silver-sat/Ground_Radio_Board/README.md

# Ground_Radio_Board
Silversat Ground Station Radio Board
