silver-sat/Ground_Radio_Board/image.png

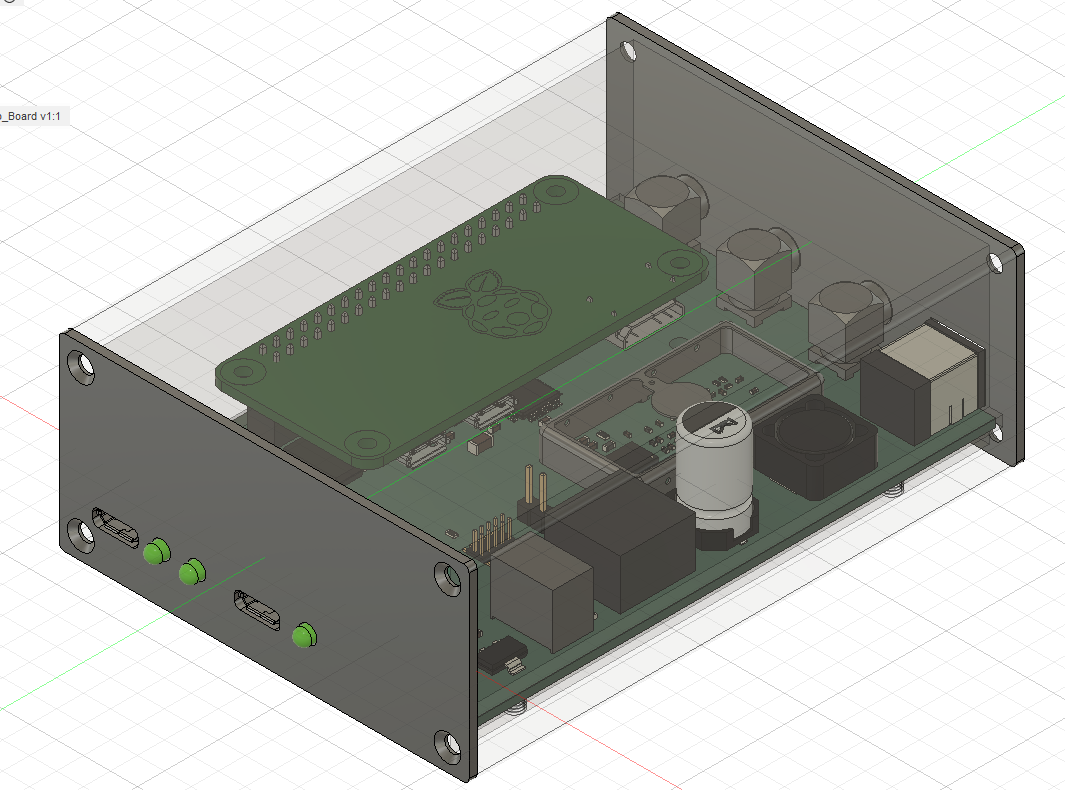
image.png
