silver-sat/Ground_Radio_Board/HeatSpreader.step

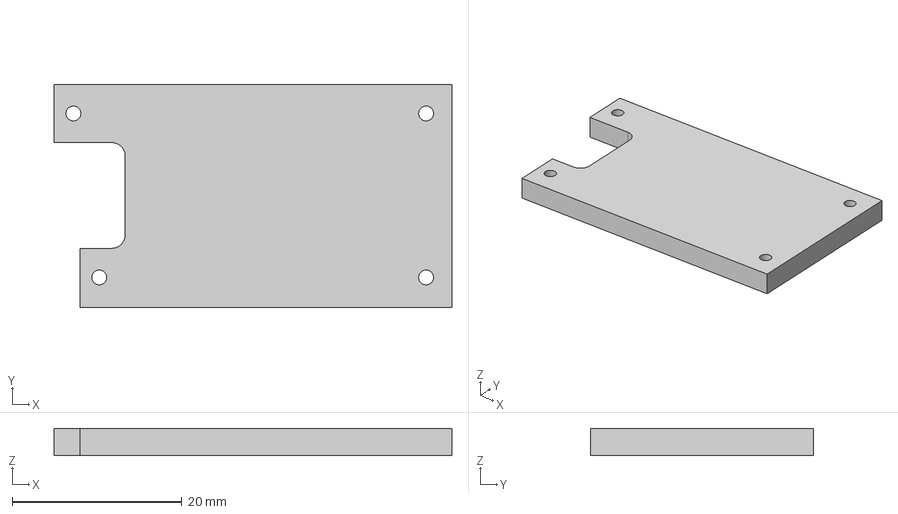
[picture p2: CAD file, 2024-04-20]
HeatSpreader.step
46.9 x 26.3 x 3.20 mm
