silver-sat/Ground_Radio_Board/3D Models/A785MW477M1VLAS015.step

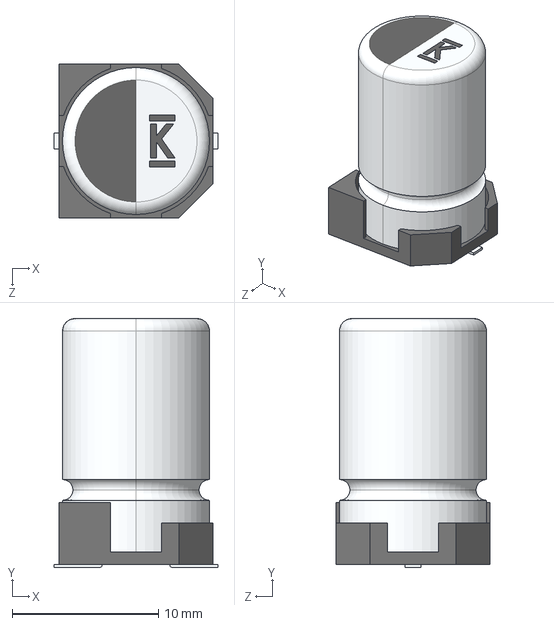
[picture p3: CAD file, 2024-08-07]
3D Models/A785MW477M1VLAS015.step
11.2 x 17.0 x 10.5 mm
