silver-sat/Ground_Radio_Board/3D Models/tsr1e_3d_drawing.stp

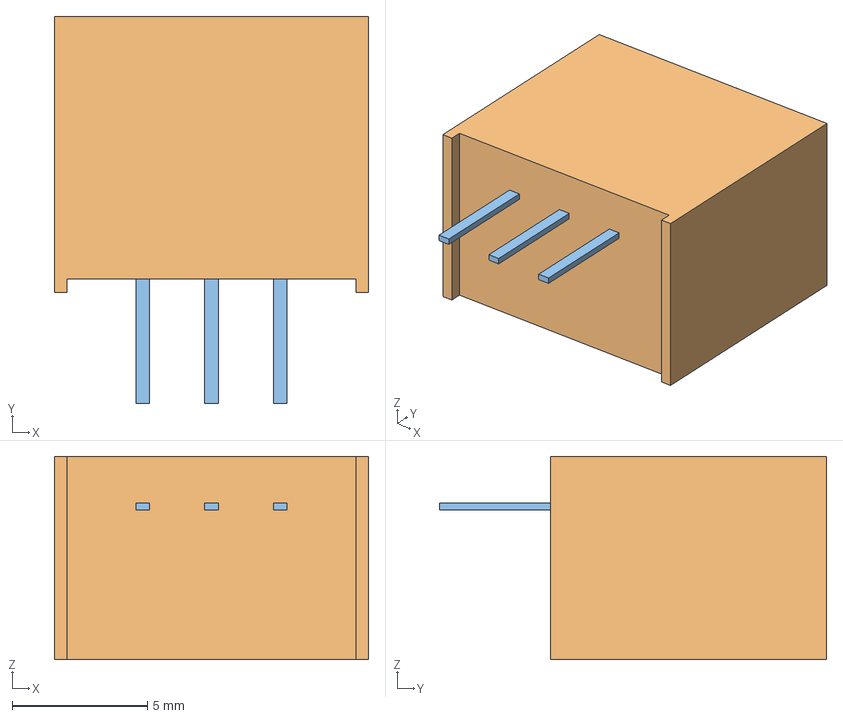
[picture p4: CAD file, 2024-08-07]
3D Models/tsr1e_3d_drawing.stp
11.6 x 14.3 x 7.50 mm
