silver-sat/Ground_Radio_Board/3D Models/srr1260.stp

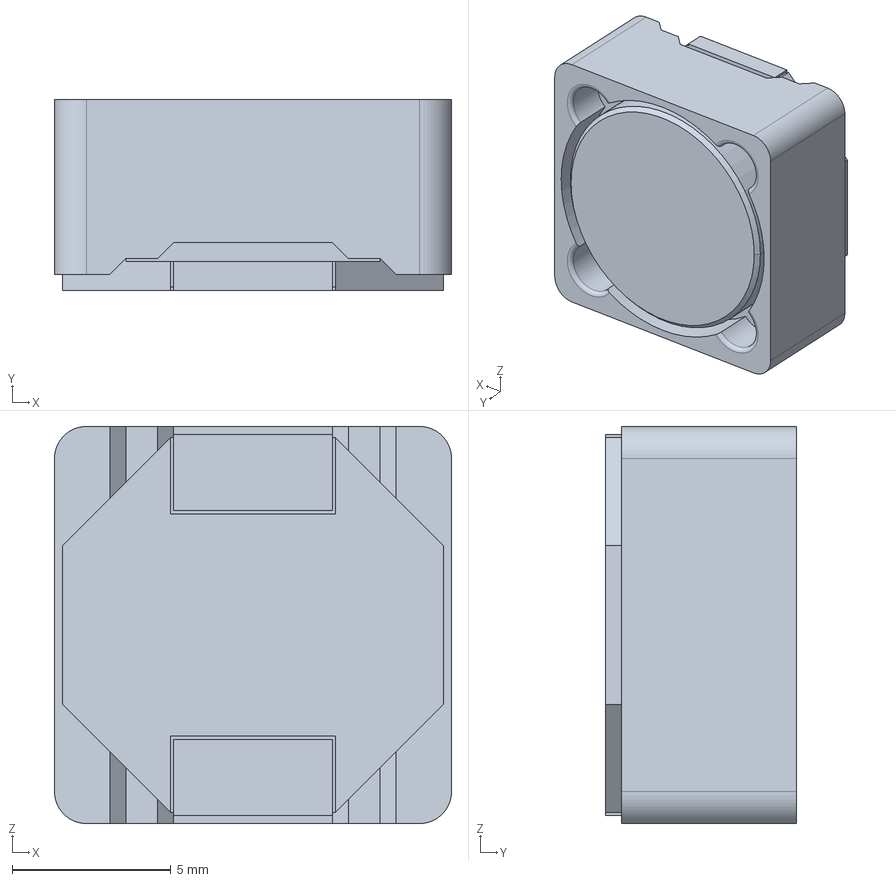
[picture p5: CAD file, 2024-08-07]
3D Models/srr1260.stp
12.5 x 6.00 x 12.5 mm
