silver-sat/Ground_Radio_Board/3D Models/PPPC202LFBN-RC.step

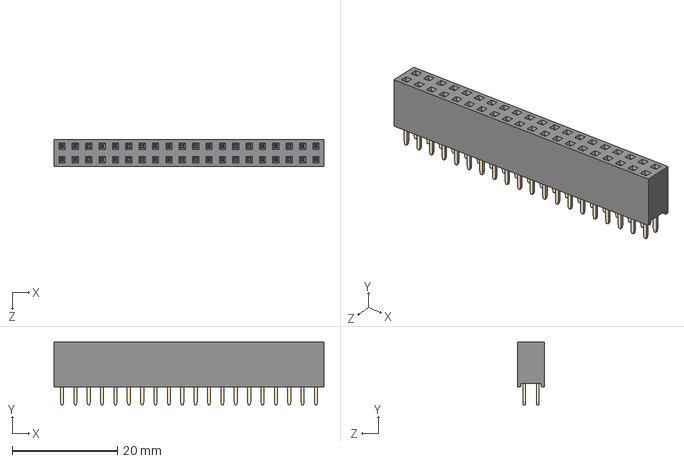
[picture p6: CAD file, 2024-08-07]
3D Models/PPPC202LFBN-RC.step
51.3 x 11.9 x 5.08 mm
2 row tin body_20
2 row tin pins x 20
