silver-sat/Ground_Radio_Board/3D Models/7447060 (rev1).stp

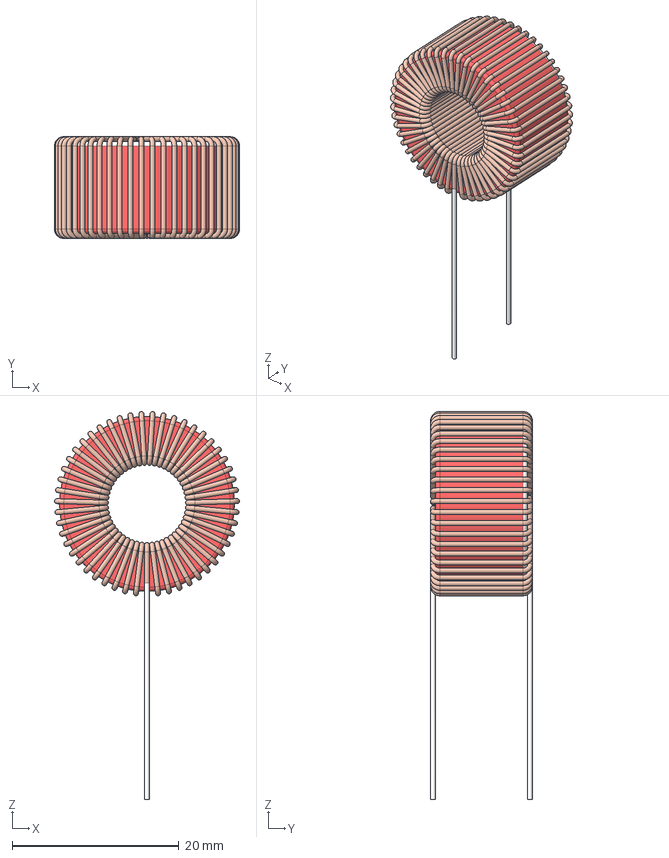
[picture p7: CAD file, 2024-08-07]
3D Models/7447060 (rev1).stp
22.2 x 12.2 x 46.6 mm
