silver-sat/Ground_Radio_Board/SilverSat_Ground_Station.kicad_pcb

## KiCad design SilverSat_Ground_Station.kicad_pcb (2024-10-12)

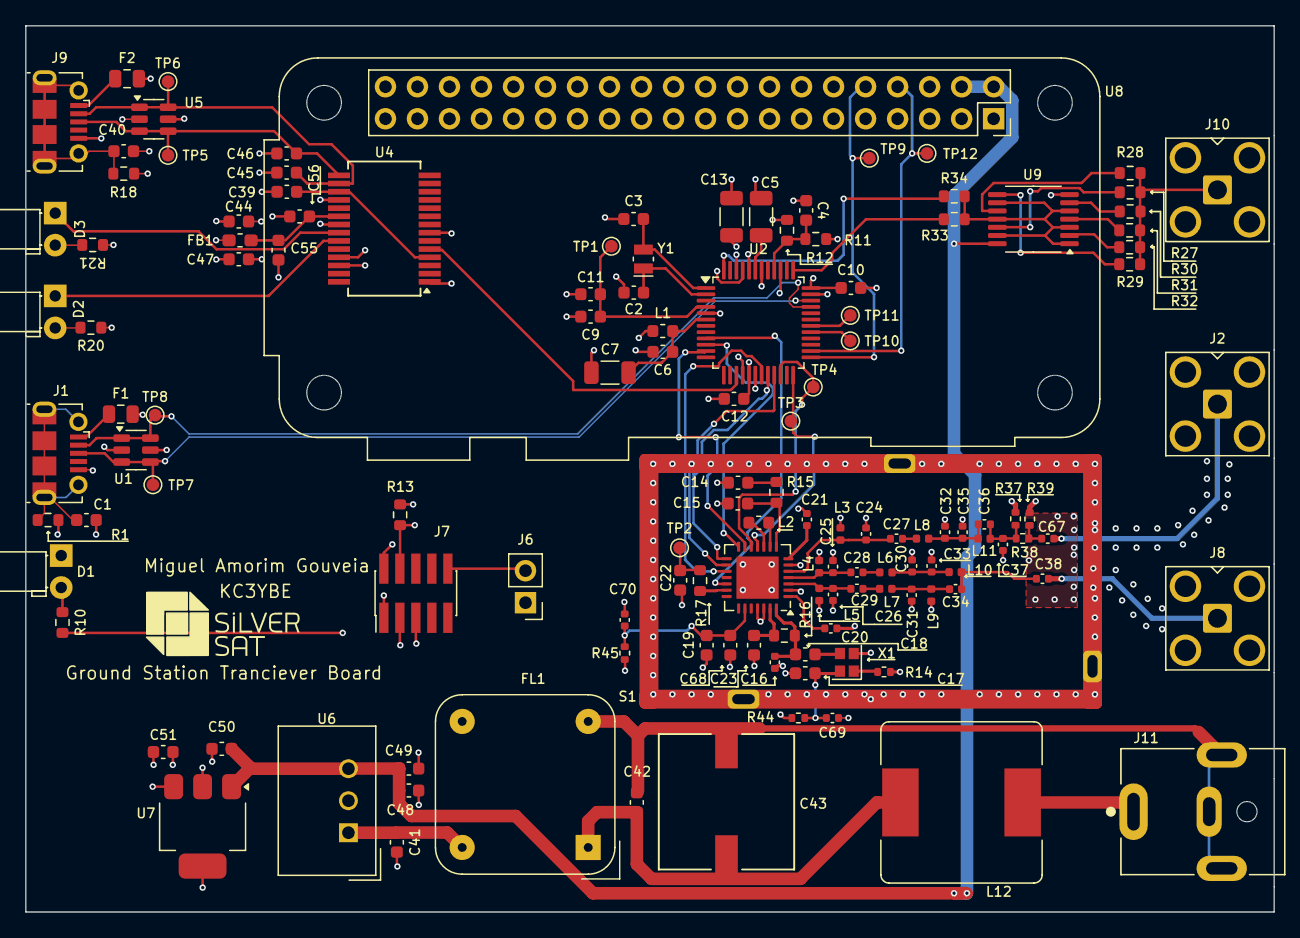
[picture p8: board SilverSat_Ground_Station.kicad_pcb from above]

Board: 4 copper layers, 99.1 x 70.3 mm, 132 parts (0 on the bottom side), 86 nets.

Parts:
C1, C14, C17, C18, C23, C40, C49, C68: 0.01u; C_0603_1608Metric
C2, C3: 20p; C_0603_1608Metric
C4, C6, C9, C10, C12, C22, C56: 0.1u; C_0603_1608Metric
C5, C7, C13: 1u; C_1206_3216Metric
C11, C19, C55: 4.7u; C_0603_1608Metric
C15: 39p; C_0603_1608Metric
C16, C24, C25, C26, C35, C37, C69, C70: DNI; C_0402_1005Metric
C20, C21, C38, C67: 100p; C_0402_1005Metric
C27, C28, C29: 4.3p; C_0402_1005Metric
C30, C31, C32: 5.6p; C_0402_1005Metric
C33, C34: 5.1p; C_0402_1005Metric
C36: 6.8p; C_0402_1005Metric
C39: 100n; C_0603_1608Metric
C41: 10u; C_0603_1608Metric
C42: 4.7p; C_0603_1608Metric
C43: 470u; CAP_EEHZ-G16_PAN
C44, C47: 10n; C_0603_1608Metric
C45, C46: 47p; C_0603_1608Metric
C48: 22u; C_0603_1608Metric
C50: 0.22u; C_0603_1608Metric
C51: DNI; C_0603_1608Metric
D1, D2, D3: LED; LED_D3.0mm_Horizontal_O1.27mm_Z2.0mm
F1, F2: 300m; Fuse_0805_2012Metric
FB1: FerriteBead; L_0603_1608Metric_Pad1.05x0.95mm_HandSolder
FL1: Choke_Schaffner_RN102-0.6-02-4M4; Choke_Schaffner_RN102-04-14.0x14.0mm
J1, J9: USB_B_Micro; USB_Micro-B_Molex-105017-0001
J2, J8, J10: Conn_Coaxial; SMA_Amphenol_901-143_Horizontal
J6: 77315-801-02LF; PinHeader_1x02_P2.54mm_Vertical
J7: PinHeader_2x05_P1.27mm_Vertical_SMD
J11: PJ-063AH; CUI_PJ-063AH
L1: Ferrite Bead; L_0603_1608Metric
L2: 10n; L_0603_1608Metric
L3, L4, L5: 0.100u; L_0402_1005Metric
L6, L7, L8: 43n; L_0402_1005Metric
L9, L10: 27n; L_0402_1005Metric
L11: 4.7n; L_0402_1005Metric
L12: L_Small; L_Bourns_SRR1260
R1, R18: 1m; R_0603_1608Metric
R10: 931; R_0603_1608Metric
R11: 330; R_0603_1608Metric
R12, R13: 10k; R_0603_1608Metric
R14, R38, R44, R45: 0; R_0402_1005Metric
R15: 12k; R_0603_1608Metric
R16: 220; R_0603_1608Metric
R17: 100; R_0603_1608Metric
R20, R21: 270R; R_0603_1608Metric
R27, R28, R29, R30, R31, R32, R33, R34: 0; R_0603_1608Metric
R37, R39: DNI; R_0402_1005Metric
S1: MS353-10C_Masach_Shield; MS355-10_Masach_Shield
TP1: AREF; TestPoint_Pad_D1.0mm
TP2, TP3, TP4, TP9, TP10, TP11, TP12: TestPoint; TestPoint_Pad_D1.0mm
TP5: USB0_D+; TestPoint_Pad_D1.0mm
TP6: USB0_D-; TestPoint_Pad_D1.0mm
TP7: USB_D+; TestPoint_Pad_D1.0mm
TP8: USB_D-; TestPoint_Pad_D1.0mm
U1, U5: USBLC6-2SC6; SOT-23-6
U2: ATSAMD21G18A-A; TQFP-48_7x7mm_P0.5mm
U3: AX5043; QFN-28-1EP_5x5mm_P0.5mm_EP3.35x3.35mm
U4: FT232RL; SSOP-28_5.3x10.2mm_P0.65mm
U6: TSR1-2450E; Converter_DCDC_TRACO_TSR1-xxxxE_THT
U7: TL1963A-33DCYR; SOT-223
U8: RaspberryPiZero(v1.1); Raspberry_Pi_Zero_Socketed_THT_FaceDown_MountingHoles
U9: 74HC04; TSSOP-14_4.4x5mm_P0.65mm
X1: TG2016SMN; Crystal_SMD_2016-4Pin_2.0x1.6mm
Y1: CM8V-T1A-32.768KHZ-12.5PF-20PPM-TB-QA; Crystal_SMD_MicroCrystal_CC8V-T1A-2Pin_2.0x1.2mm

Connections:
3V3: C10.1, C12.1, C13.2, C51.1, J7.1, L1.1, R12.1, R13.1, R44.1, R45.1, U2.17 (VDDIO), U2.36 (VDDIO), U2.44 (VDDIN), U7.3 (OUT)
+5V: C48.1, C49.1, C50.1, U6.3 (Vout), U7.1 (IN), U8.2 (5vV_Power), U8.4 (5vV_Power), U9.14 (VCC)
+5V_USB: F1.2, U1.5 (VBUS)
+5V_USB2: C44.1, C47.1, F2.2, FB1.1, R20.1, R21.1, U5.5 (VBUS)
/AX5043/Attenuator/ATN_IN: C36.2, C37.1, L11.2, R37.2, R38.1
/AX5043/Attenuator/ATN_OUT: C67.1, R38.2, R39.2
/DATA: TP3.1, U2.24 (PA15), U3.11 (DATA)
/DCLK: TP4.1, U2.22 (PA13), U3.12 (DCLK)
/Driver/TR_Out: J10.1 (In), R27.2, R28.2, R29.2, R30.2, R31.2, R32.2
/IRQ: U2.9 (PA04), U3.19 (IRQ)
/MISO: U2.21 (PA12), U3.16 (MISO)
/MOSI: U2.19 (PB10), U3.17 (MOSI)
/PA: C67.2, J2.1 (In)
/PWRAMP: C22.1, R17.2, TP2.1
/Power_Supply/vin+: J11.1, L12.1
/Power_Supply/vin-: C42.2, C43.2, FL1.3, J11.2, J11.S1 (SHIELD), J11.S2 (SHIELD__1)
/RX: C38.2, J8.1 (In)
/RXD0: U2.15 (PA10), U4.5 (RXD)
/RXD1: TP9.1, U2.25 (PA16), U8.10 (BCM_15_(RxD))
/SAMD21/AREF: C9.1, C11.1, TP1.1, U2.4 (PA03)
/SAMD21/RX_LED_SWDIO: J7.2, U2.46 (PA31)
/SAMD21/RxD2: TP11.1, U2.30 (PA21)
/SAMD21/SWCLK: J7.4, R13.2, U2.45 (PA30)
/SAMD21/TXLED: R10.2, U2.39 (PA27)
/SAMD21/TxD2: TP10.1, U2.29 (PA20)
/SAMD21/X1: C3.2, U2.1 (PA00), Y1.2
/SAMD21/X2: C2.2, U2.2 (PA01), Y1.1
/SAMD21/~RESET: J6.2, J7.10, R11.2
/SCK: U2.20 (PB11), U3.15 (CLK)
/SYSCLK: U2.11 (PA06), U3.13 (SYSCLK)
/TXD0: U2.16 (PA11), U4.1 (TXD)
/TXD1: TP12.1, U2.26 (PA17), U8.8 (BCM_14_(TxD))
/TX/~RX: R33.1, U2.37 (PB22)
/USB0_D+: C46.2, J9.3 (D+), TP5.1, U4.15 (USBD+), U5.3 (I/O2), U5.4 (I/O2)
/USB0_D-: C45.2, J9.2 (D-), TP6.1, U4.16 (USBD-), U5.1 (I/O1), U5.6 (I/O1)
/USB_D+: J1.3 (D+), TP7.1, U1.3 (I/O2), U1.4 (I/O2), U2.34 (PA25)
/USB_D-: J1.2 (D-), TP8.1, U1.1 (I/O1), U1.6 (I/O1), U2.33 (PA24)
/~SEL: U2.10 (PA05), U3.14 (SEL)
/~TX/RX: R34.1, U2.48 (PB03)
GND: C1.2, C2.1, C3.1, C4.2, C5.2, C6.2, C7.1, C9.2, C10.2, C11.2, C12.2, C13.1, C14.2, C15.2, C16.1, C17.2, C19.1, C20.2, C21.2, C22.2, C23.1, C24.1, C25.1, C26.2, C30.1, C31.2, C32.2, C33.2, C35.2, C37.2, C39.1, C40.2, C41.2, C44.2, C45.1, C46.1, C47.2, C48.2, C49.2, C50.2, C51.2, C55.2, C56.1, C68.1, C69.1, C70.1, D1.1 (K), FL1.4, J1.5 (GND), J2.2 (Ext), J6.1, J7.3, J7.5, J8.2 (Ext), J9.5 (GND), J10.2 (Ext), L3.1, L4.1, L5.2, L9.2, R1.2, R14.1, R18.2, R37.1, R39.1, S1.1 (SHIELD), U1.2 (GND), U2.5 (GNDANA), U2.18 (GND), U2.35 (GND), U2.42 (GND), U3.2 (GND), U3.6 (GND), U3.25 (GPADC1), U3.26 (GPADC2), U3.29 (GND), U4.7 (GND), U4.18 (GND), U4.21 (GND), U4.25 (AGND), U4.26 (TEST), U5.2 (GND), U6.2 (GND), U7.2 (GND), U7.4 (GND), U8.6 (GND), U8.9 (GND), U8.14 (GND), U8.20 (GND), U8.25 (GND), U8.30 (GND), U8.34 (GND), U8.39 (GND), U9.7 (GND), X1.2 (GND)
unnamed: C14.1, R15.1
unnamed: C20.1, U3.1 (VDD_ANA)
unnamed: C21.1, U3.7 (VDD_ANA)
unnamed: C27.2, L8.2
unnamed: C28.2, L6.1
unnamed: C29.1, L7.1
unnamed: C30.2, C33.1, L6.2, L10.1
unnamed: C31.1, C34.2, L7.2, L9.1
unnamed: C32.1, C35.1, C36.1, L8.1, L11.1
unnamed: C34.1, C38.1, L10.2
unnamed: C42.1, C43.1, FL1.1, L12.2
unnamed: D1.2 (A), R10.1
unnamed: D2.2 (A), R20.2
unnamed: D2.1 (K), U4.23 (CBUS0)
unnamed: D3.2 (A), R21.2
unnamed: D3.1 (K), U4.22 (CBUS1)
unnamed: C1.1, J1.6 (Shield), R1.1
unnamed: F1.1, J1.1 (VBUS)
unnamed: C40.1, J9.6 (Shield), R18.1
unnamed: F2.1, J9.1 (VBUS)
unnamed: R27.1, U9.12
unnamed: R28.1, U9.10
unnamed: R29.1, U9.8
unnamed: R30.1, U9.6
unnamed: R31.1, U9.4
unnamed: R32.1, U9.2
unnamed: R33.2, R34.2, U9.1, U9.3, U9.5, U9.9, U9.11, U9.13
unnamed: C6.1, C7.2, L1.2, U2.6 (VDDANA)
unnamed: C5.1, U2.43 (VDDCORE)
unnamed: C4.1, R11.1, R12.2, U2.40 (~RESET)
unnamed: C25.2, C28.1, L4.2, U3.4 (ANTN)
unnamed: C24.2, C27.1, L3.2, U3.5 (ANTP1)
unnamed: C26.1, C29.2, L5.1, U3.3 (ANTP)
unnamed: C23.2, R16.2, U3.27 (CLK16N)
unnamed: C16.2, C18.2, R16.1, U3.28 (CLK16P)
unnamed: C15.1, R15.2, U3.8 (FILT)
unnamed: L2.2, U3.10 (L1)
unnamed: L2.1, U3.9 (L2)
unnamed: R17.1, U3.20 (PWRAMP)
unnamed: C19.2, C68.2, C70.2, R45.2, U3.23 (VDD_IO)
unnamed: C39.2, U4.4 (VCCIO), U4.17 (3V3OUT)
unnamed: C55.1, C56.2, FB1.2, U4.20 (VCC)
unnamed: C41.1, FL1.2, U6.1 (Vin)
unnamed: C18.1, X1.3 (OUT)
unnamed: R14.2, X1.1 (VC)
unnamed: C17.1, C69.2, R44.2, X1.4 (VDD)
