silver-sat/Ground_Radio_Board/(commit log)

2024-03-13 test commit
    test of a directory commit
    [openocf.cfg]
2024-03-13 Revert "test commit"
    This reverts commit 4f2e8a94b08165137c73e908ad9e4bbcec684a32.
    [openocf.cfg]
2024-04-20 Second attempt at first commit
    [AX5043.kicad_sch, HeatSpreader.step, RPI.kicad_sch, SAMD21.kicad_sch, Serial_Converter.kicad_sch, SilverSat_Ground_Station.kicad_pcb, SilverSat_Ground_Station.kicad_sch, USB_to_RS232.kicad_sch]
2024-06-08 Started PCB design
    [AX5043.kicad_sch, RPI.kicad_sch, SilverSat_Ground_Station.kicad_pcb, SilverSat_Ground_Station.kicad_sch, driver.kicad_sch, untitled.kicad_sch, voltage_regulator.kicad_sch]
2024-06-08 Continued PCB work
    [SilverSat_Ground_Station.kicad_pcb]
2024-06-15 Worked on the driver layout
    [SilverSat_Ground_Station.kicad_pcb]
2024-06-15 Finished micro usb ports & continued PCB design
    [SilverSat_Ground_Station.kicad_pcb, untitled.kicad_sch]
2024-06-22 Worked on better layout and cleaned up some traces
    [SilverSat_Ground_Station.kicad_pcb, SilverSat_Ground_Station.kicad_sch]
2024-07-20 Finished general design & cleaned up
    [SilverSat_Ground_Station.kicad_pcb, SilverSat_Ground_Station.kicad_sch]
2024-08-03 minor fixes and additions
    added 3d bodies to RF connectors, USB connectors and power connector.
    Fixed vias attached to wrong net under Ax5043
    [SilverSat_Ground_Station.kicad_pcb]
2024-08-03 added 3d models to connectors
    I also fixed a couple of DRC errors and adjusted the design rules and stackup to match what Oshpark is using right now.
    [SilverSat_Ground_Station.kicad_pcb]
2024-08-03 Update SilverSat_Ground_Station.kicad_pcb
    added RPi. We'll need to add a connector (socket header) to raise it up
    [SilverSat_Ground_Station.kicad_pcb]
2024-08-04 New step file and board dimensions
    I had to modify the board dimensions to fit the case. I also had to move one of the RF connectors to get it out of the wall. They're spaced okay now. The panel design is based on this spacing, so if it's changed, we will have to modify the panel.
    [SilverSat_Ground_Station.kicad_pcb]
2024-08-07 Modified schematics and placement
    I removed some hardware that we were not really using to simplify the routing. I also swapped pins on the usb protectors for the same reason. I modified some components either to give them a real part number or to make them match (especially the footprints) of the satellite radio board. I also fixed a couple of schematic errors (we had conflicting 5V busses).
    I then moved the connectors to simplify routing as well, and moved a couple of blocks (nice work Miguel in putting the right parts into groups).
    Finally, I completed the design of the supply input filter. It's probably overkill, but can't hurt (even though the parts are huge!)
    [7447060 (rev1).stp, A785MW477M1VLAS015.step, AX5043.kicad_sch, PPPC202LFBN-RC.step, RN102-0.6-02-4M4.stp, RPI.kicad_sch, SAMD21.kicad_sch, SilverSat_Ground_Station.kicad_pcb]
2024-08-24 Worked on the pcb routing
    [SilverSat_Ground_Station.kicad_pcb]
2024-08-27 fixed crossovers, IO voltage and regulator part number
    Fixed crossovers on serial ports.
    Fixed IO voltage on FT232RL. IO Voltage needs to be 3V3.
    Fixed regulator part number. Part was 1.5V out, needs to be 3V3.
    [SilverSat_Ground_Station.kicad_sch, USB_to_RS232.kicad_sch, voltage_regulator.kicad_sch]
2024-08-31 Fixed SAMD21 3V3 & continued routing
    The SAMD21's 3V3 was on /SAMD21/3V3, but is now on 3V3.
    [AX5043.kicad_sch, RPI.kicad_sch, SAMD21.kicad_sch, SilverSat_Ground_Station.kicad_pcb, SilverSat_Ground_Station.kicad_sch, USB_to_RS232.kicad_sch, driver.kicad_sch, pi_net.kicad_sch]
2024-09-07 Finished general routing & started fixing errors
    Finished non 5V routing (still needs to be refined) and began working through DRC violations
    [SilverSat_Ground_Station.kicad_pcb]
2024-09-14 Cleaned up
    [SilverSat_Ground_Station.kicad_pcb]
2024-09-21 Finished Complete Design
    I just finished up the (hopefully) final design of the Ground Station transceiver. The board should now be ready to be reviewed before being bought.
    [SilverSat_Ground_Station.kicad_pcb]
2024-09-28 Final Touches
    Fixed some DRC Errors and cleaned up some of the routing. Ground Station is now completely ready for review (finally).
    [SilverSat_Ground_Station.kicad_pcb]
2024-10-05 Board Modifications After Review
    Board was reviewed and necessary modifications have been made.
    [SilverSat_Ground_Station.kicad_pcb]
2024-10-05 Changed PI model path
    I realized that the PI model path was local, so I quickly changed it to work with any computer.
    [SilverSat_Ground_Station.kicad_pcb]
2024-10-12 Finished Twice Reviewed Board Issues, And Fixed All Silkscreen.
    Finished all feedback from the second review, and gave (hopefully) everything a silkscreen version of their part number and moved them to a good location.
    [SilverSat_Ground_Station.kicad_pcb]
2024-10-12 Added SilverSat Logo and My Name
    [SilverSat_Ground_Station.kicad_pcb]
2024-11-06 Paste layer for stencil
    Gerber for stencil
    [SilverSat_Ground_Station-F_Paste.gbr]
2024-11-06 Create SilverSat_Ground_Station-job.gbrjob
    And job file
    [SilverSat_Ground_Station-job.gbrjob]
